Wami/HUD-Audi-A4-B9-MLB-Evo-Waveshare-ESP32-S3-Touch-LCD-3.49/tools/preview_nav.png

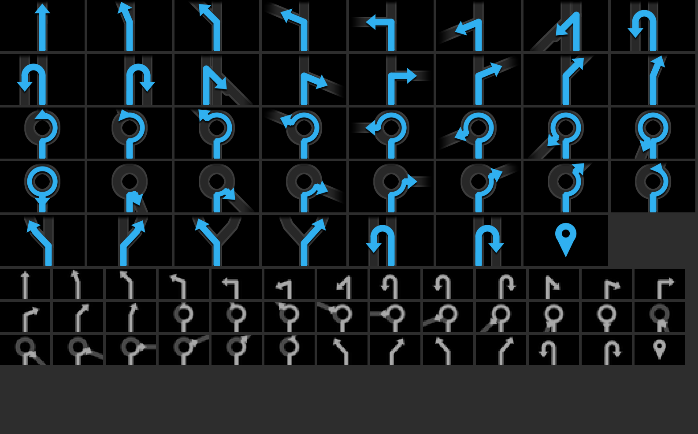
tools/preview_nav.png
