Wami/HUD-Audi-A4-B9-MLB-Evo-Waveshare-ESP32-S3-Touch-LCD-3.49/waveshare_hud_mockup/hud_ota.cpp

/*
  hud_ota.cpp — OTA по Wi-Fi: кнопка BOOT -> перезагрузка в режим обновления ->
  точка доступа + страница загрузки .bin (WebServer + Update из ядра ESP32).
  ------------------------------------------------------------------------------
  Почему через перезагрузку: в режиме обновления не работают BLE, TWAI и звук —
  Wi-Fi и загрузка получают всю память и процессор, а при обрыве старая прошивка
  остаётся нетронутой (Update переключает раздел только после успешной записи).
  Нужна таблица разделов с двумя приложениями (OTA), см. README.
*/
#include <Arduino.h>
#include <WiFi.h>
#include <WebServer.h>
#include <Update.h>
#include <Preferences.h>
#include <FFat.h>
#include "hud_config.h"
#include "hud_data.h"
#include "hud_log.h"
#include "hud_sound.h"
#include "hud_ota.h"
#include "hud_ota_logs.h"
#include "hud_diag.h"
extern "C" {
#include "hud_sounds.h"
}
#if __has_include("secrets.h")
#include "secrets.h"
#endif
#ifndef HUD_OTA_PASS
#define HUD_OTA_PASS "hud12345"           /* не короче 8 символов (WPA2); свой — в secrets.h */
#endif

static bool         s_mode = false;
static HudOtaInfo   s_info;
static portMUX_TYPE s_mux = portMUX_INITIALIZER_UNLOCKED;
static WebServer   *s_srv = nullptr;
static uint32_t     s_t0, s_restart_at;

extern "C" {

bool hud_ota_mode(void) { return s_mode; }

void hud_ota_get(HudOtaInfo *o)
{
    portENTER_CRITICAL(&s_mux);
    *o = s_info;
    portEXIT_CRITICAL(&s_mux);
}

bool hud_ota_check_boot(void)
{
    Preferences p;
    if (!p.begin("hud", false)) return false;
    bool on = p.getBool("ota", false);
    if (on) p.putBool("ota", false);           /* только один раз: следующая загрузка — обычная */
    p.end();
    s_mode = on;
    return on;
}

}

static void set_state(int st, int pct, const char *msg)
{
    portENTER_CRITICAL(&s_mux);
    s_info.state = st;
    if (pct >= 0) s_info.percent = pct;
    if (msg) { strncpy(s_info.msg, msg, sizeof s_info.msg - 1); s_info.msg[sizeof s_info.msg - 1] = 0; }
    portEXIT_CRITICAL(&s_mux);
}

/* ждём отпускания BOOT перед перезагрузкой: с зажатой GPIO0 сброс по питанию ушёл бы в режим загрузчика */
static void wait_boot_release(void)
{
    for (int i = 0; i < 100 && digitalRead(HUD_OTA_BTN_PIN) == LOW; i++) delay(30);
}

/* ---------------- обычный режим: кнопка BOOT ---------------- */
static void button_task(void *)
{
    uint32_t down = 0;
    pinMode(HUD_OTA_BTN_PIN, INPUT_PULLUP);
    for (;;) {
        vTaskDelay(pdMS_TO_TICKS(50));
        if (digitalRead(HUD_OTA_BTN_PIN) != LOW) { down = 0; continue; }
        if (!down) { down = millis(); continue; }
        if (millis() - down < HUD_OTA_HOLD_MS) continue;
        down = 0;
        HudData d;
        hud_data_snapshot(&d);
        if ((d.valid & V_SPEED) && d.speed_kmh > HUD_MENU_MAX_KMH) {       /* на ходу — игнорируем */
            hud_log_write("[ota] BOOT на ходу — игнорирую\n");
            while (digitalRead(HUD_OTA_BTN_PIN) == LOW) vTaskDelay(pdMS_TO_TICKS(50));
            continue;
        }
        hud_log_write("[ota] BOOT удержан — перезагрузка в режим обновления\n");
        hud_sound_play(hud_snd_swa_beep, hud_snd_swa_beep_len);
        hud_diag_save();                                  /* отчёт о сеансе — на страницу обновления */
        Preferences p;
        if (p.begin("hud", false)) { p.putBool("ota", true); p.end(); }
        vTaskDelay(pdMS_TO_TICKS(400));
        wait_boot_release();
        ESP.restart();
    }
}

extern "C" void hud_ota_start_button(void)
{
    xTaskCreatePinnedToCore(button_task, "hud_ota_btn", 3072, NULL, 1, NULL, 1);
}

/* ---------------- режим обновления ---------------- */
static const char PAGE[] PROGMEM = R"HTML(<!doctype html><html><head><meta charset="utf-8">
<meta name="viewport" content="width=device-width,initial-scale=1"><title>HUD update</title>
<style>body{font-family:sans-serif;max-width:480px;margin:24px auto;padding:0 16px;background:#111;color:#eee}
h1{font-size:20px}input,button{font-size:16px;margin:8px 0}button{padding:10px 18px}
progress{width:100%;height:20px}#m{margin-top:12px;min-height:24px}small{color:#999}a{color:#6cf}</style></head><body>
<h1>HUD — обновление прошивки / firmware update</h1>
<p><small>%INFO%</small></p>
<input type="file" id="f" accept=".bin"><br>
<button id="b" onclick="up()">Загрузить / Upload</button>
<progress id="p" value="0" max="100" style="display:none"></progress><div id="m"></div>
<hr><h1>База камер / camera database</h1>
<p><small>cams.bin (tools/gen_cams.py) или / or arrows.bin (tools/gen_arrow_anim.py)</small></p>
<p>Состояние / status: <b>%CAMS%</b></p>
<input type="file" id="g" accept=".bin"><br>
<button id="c" onclick="upc()">Загрузить базу / Upload database</button>
<progress id="q" value="0" max="100" style="display:none"></progress><div id="n"></div>
<hr><h1>Диагностика / Diagnostics</h1>
%DIAG%
<hr><h1>Журналы / Logs</h1>
<p><a href="/logs">Открыть журналы с SD-карты / Open logs from the SD card</a></p>
<script>
function upc(){var f=document.getElementById('g').files[0],m=document.getElementById('n'),p=document.getElementById('q');
if(!f){m.textContent='Выберите cams.bin или arrows.bin / choose cams.bin or arrows.bin';return}
var x=new XMLHttpRequest(),d=new FormData();d.append('cams',f,'cams.bin');p.style.display='block';
x.upload.onprogress=function(e){if(e.lengthComputable)p.value=100*e.loaded/e.total};
x.onload=function(){m.textContent=x.status==200?'Готово, HUD перезагружается / Done, rebooting':'Ошибка / Error: '+x.responseText};
x.onerror=function(){m.textContent='Нет связи / Connection lost'};
document.getElementById('c').disabled=true;x.open('POST','/cams');x.send(d)}
</script>
<script>
function up(){var f=document.getElementById('f').files[0],m=document.getElementById('m'),p=document.getElementById('p');
if(!f){m.textContent='Выберите .bin / choose a .bin';return}
var x=new XMLHttpRequest(),d=new FormData();d.append('fw',f,f.name);p.style.display='block';
x.upload.onprogress=function(e){if(e.lengthComputable)p.value=100*e.loaded/e.total};
x.onload=function(){m.textContent=x.status==200?'Готово, HUD перезагружается / Done, rebooting':'Ошибка / Error: '+x.responseText};
x.onerror=function(){m.textContent='Нет связи / Connection lost'};
document.getElementById('b').disabled=true;x.open('POST','/update');x.send(d)}
</script></body></html>)HTML";

static bool s_up_ok, s_up_started;
static size_t s_up_len;

static void on_upload()
{
    HTTPUpload &u = s_srv->upload();
    if (u.status == UPLOAD_FILE_START) {
        s_up_ok = false; s_up_started = true; s_up_len = 0;
        set_state(HUD_OTA_UPLOAD, 0, "");
        hud_log_write("[ota] приём файла\n");
        if (!Update.begin(UPDATE_SIZE_UNKNOWN)) {
            set_state(HUD_OTA_ERROR, -1, Update.errorString());
            s_up_started = false;
        }
    } else if (u.status == UPLOAD_FILE_WRITE && s_up_started) {
        if (Update.write(u.buf, u.currentSize) != u.currentSize) {
            set_state(HUD_OTA_ERROR, -1, Update.errorString());
            Update.abort(); s_up_started = false;
        } else {
            s_up_len += u.currentSize;
            size_t tot = s_srv->clientContentLength();                 /* размер запроса ~ размеру файла */
            if (tot > 0) set_state(HUD_OTA_UPLOAD, (int)(((s_up_len * 100) / tot) > 99 ? 99 : ((s_up_len * 100) / tot)), NULL);
            s_t0 = millis();                                            /* пока идёт загрузка — таймаут не идёт */
        }
    } else if (u.status == UPLOAD_FILE_END && s_up_started) {
        if (Update.end(true)) { s_up_ok = true; set_state(HUD_OTA_DONE, 100, ""); }
        else set_state(HUD_OTA_ERROR, -1, Update.errorString());
        s_up_started = false;
    } else if (u.status == UPLOAD_FILE_ABORTED) {
        Update.abort(); s_up_started = false;
        set_state(HUD_OTA_ERROR, -1, "upload aborted");
    }
}

/* ---------------- база камер -> /cams.bin во флеше (FATFS) ---------------- */
static bool    s_cam_ok, s_cam_started, s_cam_anm;     /* s_cam_anm: принимаем arrows.bin (ANM1), а не cams.bin (CAM1) */
static File    s_cam_file;
static size_t  s_cam_len;
static char    s_cam_err[48];

static void cam_fail(const char *why)
{
    strncpy(s_cam_err, why, sizeof s_cam_err - 1);
    set_state(HUD_OTA_ERROR, -1, why);
    if (s_cam_file) s_cam_file.close();
    FFat.remove("/cams.tmp");
    s_cam_started = false;
}

/* что лежит в /arrows.bin во флеше (для страницы портала); FATFS должен быть смонтирован */
static String arrows_file_status()
{
    File f = FFat.open("/arrows.bin", "r");
    if (!f) return "нет (обычные стрелки) / none (static arrows)";
    uint8_t h[16] = {0};
    size_t sz = f.size();
    bool rd = f.read(h, 16) == 16;
    f.close();
    if (!rd || memcmp(h, "ANM1", 4) != 0) return "повреждён / bad file";
    return String("в флеше: ") + String((unsigned)(h[8] | (h[9] << 8))) + " анимаций, " + String((unsigned)(sz / 1024)) + " КБ / in flash";
}

/* что лежит в /cams.bin во флеше (для страницы портала) */
static String cams_file_status()
{
    if (!FFat.begin(false)) return "раздел FATFS не смонтирован / FATFS not mounted";
    String arr = String(" · стрелки / arrows: ") + arrows_file_status();
    File f = FFat.open("/cams.bin", "r");
    if (!f) { FFat.end(); return "файла нет / no file" + arr; }
    uint32_t h[4] = {0};
    size_t sz = f.size();
    bool rd = f.read((uint8_t *)h, 16) == 16;
    f.close(); FFat.end();
    if (!rd || memcmp(h, "CAM1", 4) != 0) return "файл повреждён (нет CAM1) / bad file, size " + String((unsigned)sz) + arr;
    if (sz != 16 + (size_t)h[1] * 12) return "размер не сходится с заголовком / size mismatch, " + String((unsigned)sz) + arr;
    char b[24]; snprintf(b, sizeof b, "%06u", (unsigned)h[2]);
    return String("в флеше: ") + String((unsigned)h[1]) + " камер, от " + b + ", " + String((unsigned)(sz / 1024)) + " КБ / in flash" + arr;
}

/* отчёт о прошлом сеансе (снимок пишется при удержании BOOT, см. hud_diag.h) */
static String diag_html()
{
    hud_diag_t g;
    if (!hud_diag_load(&g)) return "<p><small>Нет данных: отчёт сохраняется, когда вы удерживаете BOOT в обычном режиме. / No data yet: the report is saved when BOOT is held in normal mode.</small></p>";
    static const char *const DB[] = { "не загружалась", "загружена", "нет раздела FATFS", "нет /cams.bin", "нет памяти", "файл повреждён" };
    static const char *const RR[] = { "?", "питание", "внешний", "программный", "паника", "int. watchdog", "task watchdog", "other watchdog", "deep sleep", "brownout", "SDIO" };
    String s = "<p><small>Прошлый сеанс / last session</small></p><table style='border-collapse:collapse;font-size:14px'>";
    auto row = [&](const String &k, const String &v) { s += "<tr><td style='padding:2px 10px 2px 0;color:#999'>" + k + "</td><td>" + v + "</td></tr>"; };
    uint32_t m = g.uptime_s / 60;
    row("Длительность / uptime", String((unsigned)(m / 60)) + " ч " + String((unsigned)(m % 60)) + " мин");
    row("Сброс при старте / reset", g.reset_reason < 11 ? RR[g.reset_reason] : "?");
    row("Источник / source", g.src == 1 ? "CAN" : g.src == 0 ? "BLE" : "нет связи / none");
    row("База камер / database", String(g.db_status < 6 ? DB[g.db_status] : "?") + (g.db_status == DB_OK ? String(", ") + String((unsigned)g.db_n) + " камер" : String("")));
    row("Показ / сигнал камер", String(g.cams_on ? "вкл" : "ВЫКЛ") + " / " + (g.cam_beep ? "вкл" : "выкл"));
    row("Источник камер / camera source", g.cam_src == 1 ? "телефон" : g.cam_src == 2 ? "оба" : "база");
    row("Тиков проверки / ticks", String((unsigned)g.ticks));
    row("— показ выключен", String((unsigned)g.no_cams_on));
    row("— база не загружена", String((unsigned)g.no_db));
    row("— нет GPS / курса / скорости", String((unsigned)g.no_gps) + " / " + String((unsigned)g.no_hdg) + " / " + String((unsigned)g.no_spd));
    row("— fix≠3 / спутников<4 / HDOP", String((unsigned)g.no_fix) + " / " + String((unsigned)g.no_sat) + " / " + String((unsigned)g.no_hdop));
    row("— курс не определён / скорость мала", String((unsigned)g.no_hdg_val) + " / " + String((unsigned)g.too_slow));
    row("Запросов к базе / queries", String((unsigned)g.q_run));
    row("Камера найдена (тиков) / hits", String((unsigned)g.q_hit));
    row("Показано камер / shown", String((unsigned)g.shown));
    if (g.shown) row("Последняя камера / last", "#" + String((unsigned)g.last_idx) + ", лимит " + String(g.last_lim) + ", с " + String(g.last_dist_m) + " м, v=" + String(g.last_spd));
    if (g.lat_e6 || g.lon_e6) row("Последняя позиция / last fix", String(g.lat_e6 / 1e6, 5) + ", " + String(g.lon_e6 / 1e6, 5));
    row("Макс. скорость / max speed", String(g.max_spd) + " км/ч");
    row("Телефон / phone nav", g.nav_connected ? "подключался" : "нет");
    row("— снимков / позиций", String((unsigned)g.nav_snapshots) + " / " + String((unsigned)g.nav_positions));
    row("— CRC / неизв. TLV / длина", String((unsigned)g.nav_crc) + " / " + String((unsigned)g.nav_unknown) + " / " + String((unsigned)g.nav_bad_len));
    {
        String groups;
        for (int i = 1; i <= 12; i++) {
            if (i > 1) groups += " ";
            groups += String((unsigned)g.nav_groups[i]);
        }
        row("— группы G0..G11", groups);
    }
    row("Память / free", "RAM " + String((unsigned)(g.heap_free / 1024)) + " КБ, PSRAM " + String((unsigned)(g.psram_free / 1024)) + " КБ");
    s += "</table>";
    return s;
}

static void on_cams_upload()
{
    HTTPUpload &u = s_srv->upload();
    if (u.status == UPLOAD_FILE_START) {
        s_cam_ok = false; s_cam_started = false; s_cam_anm = false; s_cam_len = 0; s_cam_err[0] = 0;
        set_state(HUD_OTA_UPLOAD, 0, "");
        hud_log_write("[ota] приём базы камер\n");
        if (!FFat.begin(true)) { cam_fail("no FATFS partition"); return; }
        FFat.remove("/cams.tmp");
        s_cam_file = FFat.open("/cams.tmp", "w");
        if (!s_cam_file) { cam_fail("cannot create file"); return; }
        s_cam_started = true;
    } else if (u.status == UPLOAD_FILE_WRITE && s_cam_started) {
        if (s_cam_len == 0) {                                    /* что за файл — по первым четырём байтам */
            if (u.currentSize >= 16 && memcmp(u.buf, "CAM1", 4) == 0)      s_cam_anm = false;
            else if (u.currentSize >= 16 && memcmp(u.buf, "ANM1", 4) == 0) s_cam_anm = true;
            else { cam_fail("not cams.bin / arrows.bin"); return; }
        }
        if (s_cam_file.write(u.buf, u.currentSize) != u.currentSize) { cam_fail("flash write failed (full?)"); return; }
        s_cam_len += u.currentSize;
        size_t tot = s_srv->clientContentLength();
        if (tot > 0) set_state(HUD_OTA_UPLOAD, (int)(((s_cam_len * 100) / tot) > 99 ? 99 : ((s_cam_len * 100) / tot)), NULL);
        s_t0 = millis();
    } else if (u.status == UPLOAD_FILE_END && s_cam_started) {
        s_cam_file.close();
        File f = FFat.open("/cams.tmp", "r");
        uint32_t hdr[4] = {0};
        bool good = f && f.read((uint8_t *)hdr, 16) == 16 &&
                    (s_cam_anm ? (f.size() == hdr[3]) : (f.size() == 16 + (size_t)hdr[1] * 12));   /* ANM1: размер файла в заголовке со смещения 12 */
        if (f) f.close();
        if (!good) { cam_fail("size does not match the header"); return; }
        const char *dst = s_cam_anm ? "/arrows.bin" : "/cams.bin";
        FFat.remove(dst);
        if (!FFat.rename("/cams.tmp", dst)) { cam_fail("rename failed"); return; }
        s_cam_ok = true; s_cam_started = false;
        set_state(HUD_OTA_DONE, 100, "");
        hud_log_write(s_cam_anm ? "[ota] анимированные стрелки записаны\n" : "[ota] база камер записана\n");
    } else if (u.status == UPLOAD_FILE_ABORTED) {
        if (s_cam_started) cam_fail("upload aborted");
    }
}

static void on_cams_done()
{
    if (s_cam_ok) {
        s_srv->send(200, "text/plain", "OK");
        s_restart_at = millis() + 2500;
    } else {
        s_srv->send(500, "text/plain", s_cam_err[0] ? s_cam_err : "failed");
        set_state(HUD_OTA_WAIT, 0, NULL);
    }
}

static void on_done()
{
    if (s_up_ok) {
        s_srv->send(200, "text/plain", "OK");
        s_restart_at = millis() + 2500;
    } else {
        HudOtaInfo i; hud_ota_get(&i);
        s_srv->send(500, "text/plain", i.msg[0] ? i.msg : "failed");
        set_state(HUD_OTA_WAIT, 0, NULL);
    }
}

static void touch_timeout(void) { s_t0 = millis(); }          /* запрос или долгая отдача файла — таймаут режима не идёт */

static void ota_task(void *)
{
    s_srv = new WebServer(80);
    s_srv->on("/", HTTP_GET, []() {
        String p = FPSTR(PAGE);
        p.replace("%INFO%", String("v" HUD_FW_VERSION " · build ") + __DATE__ + " " + __TIME__ + " · free " + String(ESP.getFreeSketchSpace() / 1024) + " KB");
        p.replace("%CAMS%", cams_file_status());
        p.replace("%DIAG%", diag_html());
        s_srv->send(200, "text/html; charset=utf-8", p);
    });
    s_srv->on("/update", HTTP_POST, on_done, on_upload);
    s_srv->on("/cams", HTTP_POST, on_cams_done, on_cams_upload);
    hud_ota_logs_attach(*s_srv, touch_timeout);                  /* /logs, /download, /download-tar, /delete */
    s_srv->onNotFound([]() { s_srv->sendHeader("Location", "/"); s_srv->send(302); });   /* captive-подобный редирект */
    s_srv->begin();
    s_t0 = millis();
    for (;;) {
        s_srv->handleClient();
        uint32_t now = millis();
        if (s_restart_at && (int32_t)(now - s_restart_at) >= 0) { hud_log_write("[ota] готово — перезагрузка\n"); ESP.restart(); }
        int32_t left_ms = (int32_t)HUD_OTA_TIMEOUT_MS - (int32_t)(now - s_t0);      /* со знаком: unsigned давал переполнение */
        int left = left_ms / 1000;
        if (left_ms <= 0) { hud_log_write("[ota] таймаут — выход\n"); ESP.restart(); }
        portENTER_CRITICAL(&s_mux); s_info.left_s = left; portEXIT_CRITICAL(&s_mux);
        /* BOOT — выйти без обновления */
        static uint32_t dn;
        if (digitalRead(HUD_OTA_BTN_PIN) == LOW) { if (!dn) dn = now; else if (now - dn > 300) { hud_log_write("[ota] выход по BOOT\n"); wait_boot_release(); ESP.restart(); } }
        else dn = 0;
        vTaskDelay(pdMS_TO_TICKS(2));
    }
}

extern "C" void hud_ota_run(void)
{
    pinMode(HUD_OTA_BTN_PIN, INPUT_PULLUP);
    WiFi.mode(WIFI_AP);
    WiFi.softAP(HUD_OTA_SSID, HUD_OTA_PASS, 6, 0, 2);
    IPAddress ip = WiFi.softAPIP();
    portENTER_CRITICAL(&s_mux);
    memset(&s_info, 0, sizeof s_info);
    strncpy(s_info.ssid, HUD_OTA_SSID, sizeof s_info.ssid - 1);
    strncpy(s_info.pass, HUD_OTA_PASS, sizeof s_info.pass - 1);
    snprintf(s_info.ip, sizeof s_info.ip, "%u.%u.%u.%u", ip[0], ip[1], ip[2], ip[3]);
    s_info.left_s = HUD_OTA_TIMEOUT_MS / 1000;
    portEXIT_CRITICAL(&s_mux);
    hud_log_write("[ota] режим обновления: Wi-Fi ");
    hud_log_write(HUD_OTA_SSID);
    hud_log_write(", http://192.168.4.1\n");
    xTaskCreatePinnedToCore(ota_task, "hud_ota", 8192, NULL, 2, NULL, 1);
}
