Wami/HUD-Audi-A4-B9-MLB-Evo-Waveshare-ESP32-S3-Touch-LCD-3.49/(commit log)

2026-11-02 Поворотник градиентом по краям. Слепые зоны градиентом
2026-11-05 исправление side assist градиентом
    [hud_mockup.c]
2026-11-05 Lane Assist для mqb с активным ведением
2026-11-05 mqb acc машина спереди по ACC_Abstandsindex
    # Conflicts:
    # waveshare_hud_mockup/can_decode.c
2026-11-05 исправление ассистентов
2026-11-06 BLE: не падать, когда сниффер не найден
    Потерянная проверка dev == nullptr после 3632cea ("fix ble connection failure"):
    без сниффера в эфире ble_task разыменовывал nullptr
    (dev->getAddress() и client->connect(dev)) -> panic и перезагрузка
    каждые ~3-4 с, пока нет связи.
    Снова пропускаем итерацию, если устройство не найдено, с clearResults()
    (иначе копятся результаты скана), паузой 1 с и сообщением в лог не чаще
    раза в 10 с.
    [ble_can_client.cpp]
2026-11-06 HUD: островки внимания — скорость в центре, навигация справа
    - скорость по центру (182…438), убрана подпись км/ч
    - навигация сдвинута вправо (x=448), дистанция и следующий манёвр сверху
    - ACC/LKA в левом краю с запасом 60 px вверх под будущее увеличение
    - знак и камера друг над другом правее ACC
    - заданная скорость ACC рядом с блоком ACC
    - маршрут одной строкой внизу справа, шрифт fuel 22
    - убраны km/h и сообще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
2026-11-06 HUD: вертикальная шкала прогресса, ниже скорость и маршрут
    - скорость опущена на 8 px (y=28)
    - горизонтальная полоска заменена вертикальной шкалой 8×140 у правого края
    - заливка снизу вверх, фон виден при наличии дистанции до манёвра
    - иконка следующего манёвра сдвинута левее, чтобы не лезть под шкалу
    - статические стрелки опущены (NAV_DY=23), анимация без изменений
    - маршрут одной строкой ниже (y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
2026-11-06 MQB: машинка ACC движется по ACC_Abstandsindex
    - перспективная шкала 10–100 м (1/d), ход 0..60 px
    - мелкий дребезг сглаживается, новая цель (вклинивание) — сразу
    - README/README_ru: поведение значка и таблица сигналов MQB
2026-11-07 MQB: машина впереди только по ACC_Abstandsindex
    - acc_object == 1 больше не используется как fallback для показа цели
    - acc_object == 2 остаётся признаком предупреждения
    - README/README_ru: уточнено назначение 45|2 в таблице MQB
2026-11-07 MQB: выпуклая шкала положения машины ACC
    - ACC_Abstandsindex — условные единицы, не метры
    - шкала откалибрована: 20 -> 0 px, 500 -> 15 px, 1021 -> 60 px
    - README/README_ru: описание и таблица сигналов MQB
2026-11-07 реализована передача данных с телефона
2026-11-08 круговое движение из телефона(без номера съезда)
2026-11-08 параметры обводки скорости мелкие правки стрелок навигации
2026-11-08 номер съезда на круговом движении цифрой в центре круга
2026-11-08 скрывать иконку подключения
2026-11-08 правка фонового свечения
2026-11-08 прогрессбар для данных с телефона
